Edgar-Conzen/EC16_on_ICE/EC16_ISA_V1.0.pdf

## EC16 Microprocessor Core

Instruction Set Architecture V1.0

## Summary

The EC16 is a microprocessor core written in VHDL with the following features

- 64K * 16-bit external memory space for code, data and I/O
- 256 * 16-bit internal ram for registers, pointers, stack and scratchpad
- 50 instructions
- instruction length: 46x one word, 4x two words
- speed: 18 one-cycle, 15 two-cycle, 9 three-cycle, 8 one/two-cycle (branch)
- 4 maskable prioritized interrupts

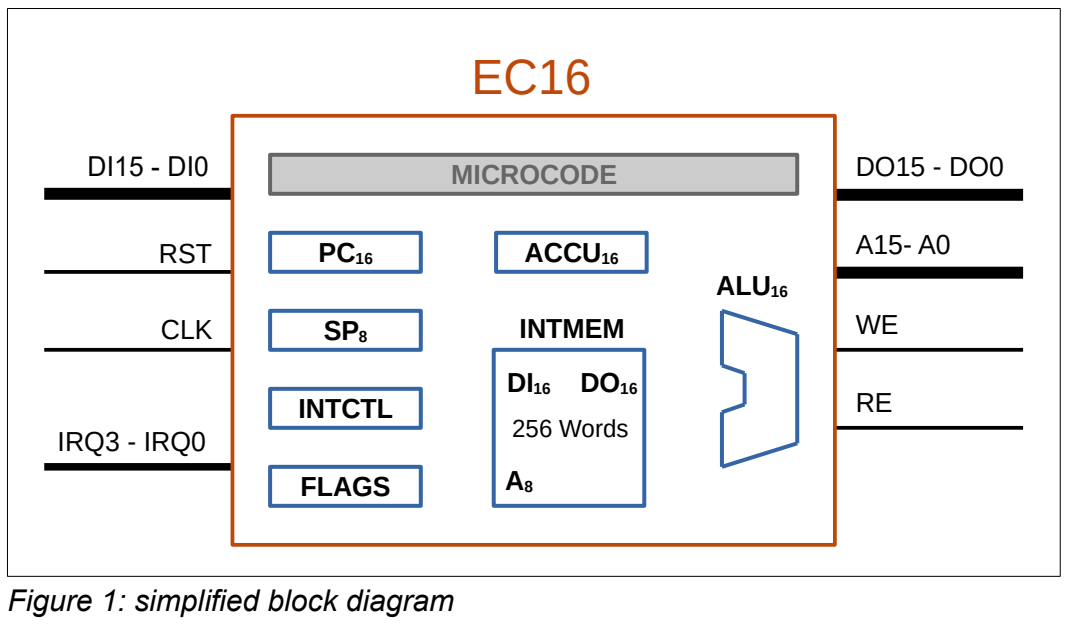
[picture p4: figure]
ACCU16; FLAGS; ALU16; INTMEM; 256 Words; INTCTL; MICROCODE; IRQ3 - IRQ0; CLK; RST; Figure 1: simplified block diagram

EC16 ISA V1.0 | Page 1/52

## EC16 Microprocessor Core

## Memory Model

The EC16 has two completely separate memory spaces, the external memory space (EXTMEM) and a small but faster accessible internal memory (INTMEM).

While the EXTMEM space can be populated as required with ram, rom and I/O devices, the INTMEM space is always fully populated with an EBRam organized as 256 x 16 bit.

The INTMEM cells can be used as registers, pointers to INTMEM or EXTMEM locations, scratchpad ram or stack space. The stack pointer is a separate register that is initialized to 0xFF at reset and grows towards 0x00. The usual caution has to be exercised to avoid a conflict between the growing stack and the other variables.

The EXTMEM must be populated with at least a small amount of ROM (pre-initialized RAM) beginning at address 0 since the reset and interrupt vectors are located there. The rest of the address space can be used as required.

The EC16 has a reduced instruction set architecture that is strongly focussed on the use of the faster INTMEM. Each of the 256 INTMEM locations can be used as a register or a pointer and its 8-bit address is encoded in the lower half of the opcode which speeds up fetch- and execution time. Read and write access to the EXTMEM space is handled by

Page 2/52 | EC16 ISA V1.0

External Memory (EXTMEM)
64K x 16 bit
0xFFFF

Code, Data, I/O

0x0020 | IRQ3
0x0018 | IRQ2
0x0010 | IRQ1
0x0008 | IRQ0
0x0000 | Reset

Internal Memory (INTMEM)
256 x 16 bit

Registers
Pointers
Sratchpad

0xFF
0x00

Stackpointer

## EC16 Microprocessor Core

only two instructions (MOVXI A INTMEM / MOVXI INTMEM A), both of which use an INTMEM cell to provide the address (indirect addressing via pointer). Nevertheless block operations can be very efficiently implemented with only three registers (source, destination and counter), in combination with the INC/DEC- and branch instructions.

## Interrupts

The EC16 has four interrupt inputs : IRQ0 – IRQ3. IRQ0 has the highest, IRQ3 the lowest priority. All four interupts are triggered by a rising edge. Prioritization and execution are handled via the INTCTL block. This block contains i.a. three registers : IRR (Interrupt Request Register), IMASK and IIP (Interrupt In Progress).

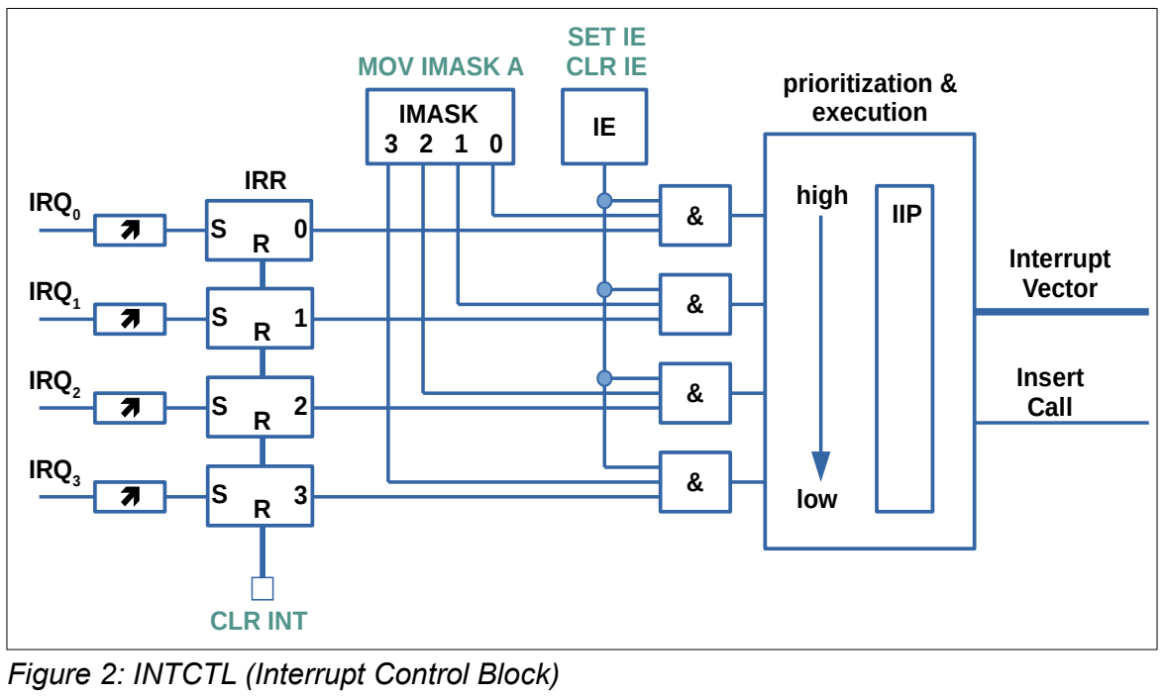
[picture p5: figure]
IMASK 3 2 1 0; IRQ0; IRQ1; IRQ2; IRQ3; CLR INT; IRR; MOV IMASK A; SET IE CLR IE; IIP; Interrupt Vector; Insert Call; prioritization & execution; high; low

A rising edge on IRQn is always registered in IRRn regardless of the state of IMASKn and IE. If, however, the rising edge occurs in the same clock cycle as a CLR INT instruction (which resets all IRR flags at once), the clear instruction takes precedence.

Figure 2: INTCTL (Interrupt Control Block)

## EC16 Microprocessor Core

IMASKn enables (1) or disables (0) IRQn. IMASK can be written with a MOV IMASK A instruction, which transfers the four least significant bits of the AKKU to IMASK3-0.

The flag IE enables (1) or disables (0) all interrupts simultaneously. IE can be set/reset with the SET IE, CLR IE and the MOV FLAGS A instructions.

Unless it is cleared by a CLR INT instruction, the IRRn flag remains set until its interrupt is executed. Interrupt execution happens as soon as IRRn , IMASKn and IE are all set and no interrupt with higher priority is in progress.

The current instruction is finished, IRRn is cleared and IIPn is set instead, blocking all lower level interrupts. Then the address of the next instruction is pushed onto the stack and a call to the corresponding interrupt vector is executed. IIPn stays set until the interrupt service routine is finished with a RETI instruction. RETI clears IIPn, pops the return address from the stack and resumes executing from where it left of.

Notice that as soon as IRRn is cleared, it will register the next rising edge on IRQn, even if the current ISR (Interrupt Service Routine) is still in progress.

Notice furthermore that at least one instruction of the interrupted program context is executed before the next interrupt is taken.

An IRQ with higher priority will interrupt the current ISR. This can be avoided if necessary by temporarily clearing the IE flag. Typical examples are atomic operations like a read-modify-write access to a peripheral or the handling of semaphores. Only the crucial instructions should be framed by a pair of CLR IE and SET IE.

Each interrupt level needs one word of stack space for the return address. No variables, registers or flags are saved automatically. It is up to the user to take care of it.

Page 4/52 | EC16 ISA V1.0

## EC16 Microprocessor Core

## Instruction Set

The EC16 opcodes consist of three fields

15 | 14 | 13 | 12 | 11 | 10 | 9 | 8 | 7 | 6 | 5 | 4 | 3 | 2 | 1 | 0
CYC1 | CYC0 | INST5 | INST4 | INST3 | INST2 | INST1 | INST0 | IA7 | IA6 | IA5 | IA4 | IA3 | IA2 | IA1 | IA0
- Bit 15:14 - CYC1:0 : number of clock cycles
- Bit 13:8 - INST5:0 : instruction index
- Bit 7:0 - IA7:0 : depending on instruction :
- INTMEM address (8 bit unsigned)
- Branch offset (8 bit signed)
- 0 if none of the above applies

Only the instructions JMPD U16, CALLD U16, LOAD A U16 and LOAD INTMEM U16 are two-word instructions, i.e. the opcode is followed by a 16 bit constant. In case of JMPD and CALLD this is the target address, in case of LOAD the value is loaded into the Accu respectively the INTMEM cell.

CYC1:0 | Number of clock cycles
00 | 1
01 | 2
10 | 3
11 | 2/1 (branch/no branch)

## EC16 Microprocessor Core

Instructions sorted by Function

Mnemonic | OPCode | Cycles | Words Arithmetic
ADD A INTMEM | 43u8 | 2 | 1 | A ← A + INTMEM
ADDC A INTMEM | 41u8 | 2 | 1 | A ← A + INTMEM + CARRY
CMP A INTMEM | 44u8 | 2 | 1 | Compare A and INTMEM
DEC INTMEM | 46u8 | 2 | 1 | Decrement INTMEM
INC INTMEM | 47u8 | 2 | 1 | Increment INTMEM
SUB A INTMEM | 42u8 | 2 | 1 | A ← A - INTMEM
SUBB A INTMEM | 40u8 | 2 | 1 | A ← A - INTMEM - CARRY
Logic
AND A INTMEM | 4Cu8 | 2 | 1 | A ← A AND INTMEM
NOT A | 2F00 | 1 | 1 | A ← ~A
OR A INTMEM | 4Du8 | 2 | 1 | A ← A OR INTMEM
ROL A | 2800 | 1 | 1 | C ← A(15 ← 14 ← … ← 2 ← 1 ← 0) ← C
ROR A | 2900 | 1 | 1 | C → A(15 → 14 → … → 2 → 1 → 0) → C
SHL A | 2A00 | 1 | 1 | C ← A(15 ← 14 ← … ← 2 ← 1 ← 0) ← '0'
SHR A | 2B00 | 1 | 1 | '0' → A(15 → 14 → … → 2 → 1 → 0) → C
SWAP A | 2500 | 1 | 1 | A ← A(15..8) A(7..0)
XOR A INTMEM | 4Eu8 | 2 | 1 | A ← A XOR INTMEM
Flag Manipulation
CLR C | 1000 | 1 | 1 | Clear CARRY flag
CLR IE | 0200 | 1 | 1 | Clear Interrupt Enable flag
CLR INT | 0400 | 1 | 1 | Clear all pending interrupts
SET C | 1100 | 1 | 1 | Set CARRY flag
SET IE | 0300 | 1 | 1 | Set Interrupt Enable flag
Program Flow Control
BRCC S8 | C0s8 | 2/1 | 1 | Branch if CARRY flag is '0'
BRCS S8 | C4s8 | 2/1 | 1 | Branch if CARRY flag is '1'
BRNC S8 | C2s8 | 2/1 | 1 | Branch if NEG flag is '0'
BRNS S8 | C6s8 | 2/1 | 1 | Branch if NEG flag is '1'
BROC S8 | C1s8 | 2/1 | 1 | Branch if OV flag is '0'
BROS S8 | C5s8 | 2/1 | 1 | Branch if OV flag is '1'
BRZC S8 | C3s8 | 2/1 | 1 | Branch if ZERO flag is '0'
BRZS S8 | C7s8 | 2/1 | 1 | Branch if ZERO flag is '0'
CALLD U16 | A100 | 3 | 2 | Call subroutine, Direct 16-bit EXTMEM address
CALLI INTMEM | A3u8 | 3 | 1 | Call subroutine, Indirect via pointer in INTMEM
JMPD U16 | A000 | 3 | 2 | Jump to Direct 16-bit EXTMEM address
JMPI INTMEM | A2u8 | 3 | 1 | Jump Indirect via pointer in INTMEM
RETI | 8500 | 3 | 1 | Return from Interrupt
RETS | 8400 | 3 | 1 | Return from Subroutine
Data Transport
LOAD A U16 | 6000 | 2 | 2 | Load 16-bit value into A
LOAD INTMEM U16 | 61u8 | 2 | 2 | Load 16-bit value into INTMEM
Page 6/52 | EC16 ISA V1.0

## EC16 Microprocessor Core

MOV A INTMEM | 50u8 | 2 | 1 | Move INTMEM to A
MOV A STATUS | 1400 | 1 | 1 | Move SP, IE and Flags to A
MOV FLAGS A | 1200 | 1 | 1 | Move A to Flags
MOV IMASK A | 0500 | 1 | 1 | Move A to Interrupt Mask
MOV INTMEM A | 16u8 | 1 | 1 | Move A to INTMEM
MOV SP A | 1300 | 1 | 1 | Move A to SP
MOVI A INTMEM | 80u8 | 3 | 1 | Move Indirect INTMEM to A. (See below)
MOVI INTMEM A | 52u8 | 2 | 1 | Move A to Indirect INTMEM. (See below)
MOVXI A INTMEM | 83u8 | 3 | 1 | Move EXTMEM (via pointer in INTMEM) to A
MOVXI INTMEM A | 82u8 | 3 | 1 | Move A (via pointer in INTMEM) to EXTMEM
POP A | 5100 | 2 | 1 | Pop value from Stack to A
PUSH A | 1500 | 1 | 1 | Push value in A to Stack
Miscellaneous
NOP | 0000 | 1 | 1 | No operation

Instructions sorted by Mnemonic

Mnemonic | OPCode | Cycles | Words | Action
ADD A INTMEM | 43u8 | 2 | 1 | A ← A + INTMEM
ADDC A INTMEM | 41u8 | 2 | 1 | A ← A + INTMEM + CARRY
AND A INTMEM | 4Cu8 | 2 | 1 | A ← A AND INTMEM
BRCC S8 | C0s8 | 2/1 | 1 | Branch if CARRY flag is '0'
BRCS S8 | C4s8 | 2/1 | 1 | Branch if CARRY flag is '1'
BRNC S8 | C2s8 | 2/1 | 1 | Branch if NEG flag is '0'
BRNS S8 | C6s8 | 2/1 | 1 | Branch if NEG flag is '1'
BROC S8 | C1s8 | 2/1 | 1 | Branch if OV flag is '0'
BROS S8 | C5s8 | 2/1 | 1 | Branch if OV flag is '1'
BRZC S8 | C3s8 | 2/1 | 1 | Branch if ZERO flag is '0'
BRZS S8 | C7s8 | 2/1 | 1 | Branch if ZERO flag is '0'
CALLD U16 | A100 | 3 | 2 | Call subroutine, Direct 16-bit EXTMEM address
CALLI INTMEM | A3u8 | 3 | 1 | Call subroutine, Indirect via pointer in INTMEM
CLR C | 1000 | 1 | 1 | Clear CARRY flag
CLR IE | 0200 | 1 | 1 | Clear Interrupt Enable flag
CLR INT | 0400 | 1 | 1 | Clear all pending interrupts
CMP A INTMEM | 44u8 | 2 | 1 | Compare A and INTMEM
DEC INTMEM | 46u8 | 2 | 1 | Decrement INTMEM
INC INTMEM | 47u8 | 2 | 1 | Increment INTMEM
JMPD U16 | A000 | 3 | 2 | Jump to Direct 16-bit EXTMEM address
JMPI INTMEM | A2u8 | 3 | 1 | Jump Indirect via pointer in INTMEM
LOAD A U16 | 6000 | 2 | 2 | Load 16-bit value into A
LOAD INTMEM U16 | 61u8 | 2 | 2 | Load 16-bit value into INTMEM
MOV A INTMEM | 50u8 | 2 | 1 | Move INTMEM to A
MOV A STATUS | 1400 | 1 | 1 | Move SP, IE and Flags to A
MOV FLAGS A | 1200 | 1 | 1 | Move A to Flags
MOV IMASK A | 0500 | 1 | 1 | Move A to Interrupt Mask
MOV INTMEM A | 16u8 | 1 | 1 | Move A to INTMEM
MOV SP A | 1300 | 1 | 1 | Move A to SP

## EC16 Microprocessor Core

MOVI A INTMEM | 80u8 | 3 | 1 | Move Indirect INTMEM to A. (See below)
MOVI INTMEM A | 52u8 | 2 | 1 | Move A to Indirect INTMEM. (See below)
MOVXI A INTMEM | 83u8 | 3 | 1 | Move EXTMEM (via pointer in INTMEM) to A
MOVXI INTMEM A | 82u8 | 3 | 1 | Move A (via pointer in INTMEM) to EXTMEM
NOP | 0000 | 1 | 1 | No operation
NOT A | 2F00 | 1 | 1 | A ← ~A
OR A INTMEM | 4Du8 | 2 | 1 | A ← A OR INTMEM
POP A | 5100 | 2 | 1 | Pop value from Stack to A
PUSH A | 1500 | 1 | 1 | Push value in A to Stack
RETI | 8500 | 3 | 1 | Return from Interrupt
RETS | 8400 | 3 | 1 | Return from Subroutine
ROL A | 2800 | 1 | 1 | C ← A(15 ← 14 ← … ← 2 ← 1 ← 0) ← C
ROR A | 2900 | 1 | 1 | C → A(15 → 14 → … → 2 → 1 → 0) → C
SET C | 1100 | 1 | 1 | Set CARRY flag
SET IE | 0300 | 1 | 1 | Set Interrupt Enable flag
SHL A | 2A00 | 1 | 1 | C ← A(15 ← 14 ← … ← 2 ← 1 ← 0) ← '0'
SHR A | 2B00 | 1 | 1 | '0' → A(15 → 14 → … → 2 → 1 → 0) → C
SUB A INTMEM | 42u8 | 2 | 1 | A ← A - INTMEM
SUBB A INTMEM | 40u8 | 2 | 1 | A ← A - INTMEM - CARRY
SWAP A | 2500 | 1 | 1 | A ← A(15..8) A(7..0)
XOR A INTMEM | 4Eu8 | 2 | 1 | A ← A XOR INTMEM

Instructions sorted by OPCode

Mnemonic | OPCode | Cycles | Words
NOP | 0000 | 1 | 1 | No operation
CLR IE | 0200 | 1 | 1 | Clear Interrupt Enable flag
SET IE | 0300 | 1 | 1 | Set Interrupt Enable flag
CLR INT | 0400 | 1 | 1 | Clear all pending interrupts
MOV IMASK A | 0500 | 1 | 1 | Move A to Interrupt Mask
CLR C | 1000 | 1 | 1 | Clear CARRY flag
SET C | 1100 | 1 | 1 | Set CARRY flag
MOV FLAGS A | 1200 | 1 | 1 | Move A to Flags
MOV SP A | 1300 | 1 | 1 | Move A to SP
MOV A STATUS | 1400 | 1 | 1 | Move SP, IE and Flags to A
PUSH A | 1500 | 1 | 1 | Push value in A to Stack
MOV INTMEM A | 16u8 | 1 | 1 | Move A to INTMEM
SWAP A | 2500 | 1 | 1 | A ← A(15..8) A(7..0)
ROL A | 2800 | 1 | 1 | C ← A(15 ← 14 ← … ← 2 ← 1 ← 0) ← C
ROR A | 2900 | 1 | 1 | C → A(15 → 14 → … → 2 → 1 → 0) → C
SHL A | 2A00 | 1 | 1 | C ← A(15 ← 14 ← … ← 2 ← 1 ← 0) ← '0'
SHR A | 2B00 | 1 | 1 | '0' → A(15 → 14 → … → 2 → 1 → 0) → C
NOT A | 2F00 | 1 | 1 | A ← ~A
SUBB A INTMEM | 40u8 | 2 | 1 | A ← A - INTMEM - CARRY
ADDC A INTMEM | 41u8 | 2 | 1 | A ← A + INTMEM + CARRY
SUB A INTMEM | 42u8 | 2 | 1 | A ← A - INTMEM
ADD A INTMEM | 43u8 | 2 | 1 | A ← A + INTMEM
Page 8/52 | EC16 ISA V1.0

## EC16 Microprocessor Core

CMP A INTMEM | 44u8 | 2 | 1 | Compare A and INTMEM
DEC INTMEM | 46u8 | 2 | 1 | Decrement INTMEM
INC INTMEM | 47u8 | 2 | 1 | Increment INTMEM
AND A INTMEM | 4Cu8 | 2 | 1 | A ← A AND INTMEM
OR A INTMEM | 4Du8 | 2 | 1 | A ← A OR INTMEM
XOR A INTMEM | 4Eu8 | 2 | 1 | A ← A XOR INTMEM
MOV A INTMEM | 50u8 | 2 | 1 | Move A to INTMEM
POP A | 5100 | 2 | 1 | Pop value from Stack to A
MOVI INTMEM A | 52u8 | 2 | 1 | Move A to Indirect INTMEM. (See below)
LOAD A U16 | 6000 | 2 | 2 | Load 16-bit value into A
LOAD INTMEM U16 | 61u8 | 2 | 2 | Load 16-bit value into INTMEM
MOVI A INTMEM | 80u8 | 3 | 1 | Move Indirect INTMEM to A. (See below)
MOVXI INTMEM A | 82u8 | 3 | 1 | Move A (via pointer in INTMEM) to EXTMEM
MOVXI A INTMEM | 83u8 | 3 | 1 | Move EXTMEM (via pointer in INTMEM) to A
RETS | 8400 | 3 | 1 | Return from Subroutine
RETI | 8500 | 3 | 1 | Return from Interrupt
JMPD U16 | A000 | 3 | 2 | Jump to Direct 16-bit EXTMEM address
CALLD U16 | A100 | 3 | 2 | Call subroutine, Direct 16-bit EXTMEM address
JMPI INTMEM | A2u8 | 3 | 1 | Jump Indirect via pointer in INTMEM
CALLI INTMEM | A3u8 | 3 | 1 | Call subroutine, Indirect via pointer in INTMEM
BRCC S8 | C0s8 | 2/1 | 1 | Branch if CARRY flag is '0'
BROC S8 | C1s8 | 2/1 | 1 | Branch if OV flag is '0'
BRNC S8 | C2s8 | 2/1 | 1 | Branch if NEG flag is '0'
BRZC S8 | C3s8 | 2/1 | 1 | Branch if ZERO flag is '0'
BRCS S8 | C4s8 | 2/1 | 1 | Branch if CARRY flag is '1'
BROS S8 | C5s8 | 2/1 | 1 | Branch if OV flag is '1'
BRNS S8 | C6s8 | 2/1 | 1 | Branch if NEG flag is '1'
BRZS S8 | C7s8 | 2/1 | 1 | Branch if ZERO flag is '0'

## EC16 Microprocessor Core

ADD A INTMEM | OP-Code | Arg | Words | Cycles
43u8 | - | 1 | 2

Function:
ACCU ← ACCU + INTMEM(u8);
PC ← PC + 1
Affected Flags: ZERO, NEG, OVER, CARRY

Description:
Add ACCU and INTMEM.
The contents of ACCU and INTMEM (addressed by the lower 8 bits of the OP-Code) are added and the result is stored into the ACCU.
The flags are affected as follows:
- ZERO | set when the result is zero, otherwise cleared
- NEG | set when d15 of result is one, otherwise cleared
- OVER | set when sign overflows, otherwise cleared
- CARRY | set when result is bigger than 16 bits, otherwise cleared

Remarks:
This instruction does not add the current CARRY to the two summands. It can be used for a 16-bit addition or to add the lowest two words in a higher precision (e.g. 64-bit) addition.
Page 10/52 | EC16 ISA V1.0

## EC16 Microprocessor Core

ADDC A INTMEM | OP-Code | Arg | Words | Cycles
41u8 | - | 1 | 2

Function:
ACCU ← ACCU + INTMEM(u8) + CARRY; PC ← PC + 1
Affected Flags: ZERO, NEG, OVER, CARRY

Description:
ADD CARRY, ACCU and INTMEM.
The contents of ACCU, INTMEM (addressed by the lower 8 bits of the OP-Code) and CARRY flag are added and the result is stored into ACCU.
The flags are affected as follows:
- ZERO | set when the result is zero, otherwise cleared
- NEG | set when d15 of result is one, otherwise cleared
- OVER | set when sign overflows, otherwise cleared
- CARRY | set when result is bigger than 16 bits, otherwise cleared

Remarks:
ADDC is normally used in higher precision (e.g. 64-bit) additions. At first the lowest two words are added with the ADD instruction. Then the higher words are added with the ADDC instruction, taking the carries into account.

## EC16 Microprocessor Core

AND A INTMEM | OP-Code | Arg | Words | Cycles
4Cu8 | - | 1 | 2

Function:
ACCU ← ACCU AND INTMEM(u8) PC ← PC + 1
Affected Flags: ZERO, NEG, OVER

Description:
And ACCU and INTMEM.
The contents of ACCU and INTMEM (addressed by the lower 8 bits of the OP-Code) are ANDed bit-wise and the result is stored into the ACCU.
The flags are affected as follows:
- ZERO | set when the result is zero, otherwise cleared
- NEG | set when d15 of result is one, otherwise cleared
- OVER | set to zero

Remarks:
none
Page 12/52 | EC16 ISA V1.0

## EC16 Microprocessor Core

BRxx | OP-Code | Arg | Words | Cycles
| Cxs8 | - | 1 | 2/1

Function:
Conditional branch
If condition is false then PC ← PC + 1
If condition is true then PC ← PC + s8 (branch)

Description:
Branch on (flag) clear / set.
If the condition is not met, the program simply continues with the next instruction. This takes one cycle.
If the condition is met, the offset (sign extended lower half of the OP-Code) is added to the program counter (PC). At this moment the PC is already pointing to the instruction following the branch instruction. So an offset of 0 will act as if no branch was taken. An offset of -1 will set the PC back to the branch instruction itself, thus creating an infinite loop. A branch reaches from -127 to +128 of its own address and takes two cycles.

x = branch taken
FLAG | CARRY | NEG | OVER | ZERO
Mnemonic (Opcode) | 0 | 1 | 0 | 1 | 0 | 1 | 0 | 1
BRCC (C0s8) | x
BRCS (C4s8) | | x
BRNC (C2s8) | | | x
BRNS (C6s8) | | | | x
BROC (C1s8) | | | | | x
BROS (C5s8) | | | | | | x
BRZC (C3s8) | | | | | | | x
BRZS (C7s8) | | | | | | | | x

Remarks: none

## EC16 Microprocessor Core

CALLD U16 | OP-Code | Arg | Words | Cycles
A100 | #U16 | 2 | 3

Function:
INTMEM(SP) ← PC
PC ← #U16
Affected Flags: none

Description:
Call direct address.
The call address is the argument, i.e. the word following the opcode. First the return address, which is the address of the instruction following the argument, is pushed onto the stack. Then the PC is loaded with the call address and execution continues there.

Remarks:
One word of stack space must be available
Page 14/52 | EC16 ISA V1.0

## EC16 Microprocessor Core

CALLI INTMEM | OP-Code | Arg | Words | Cycles
A3u8 | - | 1 | 3

Function:
INTMEM(SP) ← PC+1
PC ← INTMEM(u8)
Affected Flags: none

Description:
Call indirect via pointer in INTMEM.
The call address is in INTMEM (which is addressed by the lower 8 bits of the OP-Code). First the return address, which is the address of the instruction following the CALL, is pushed onto the stack. Then the PC is loaded with the call address and execution continues there.

Remarks:
One word of stack space must be available

## EC16 Microprocessor Core

CLR C | OP-Code | Arg | Words | Cycles
1000 | - | 1 | 1

Function:
CARRY ← 0
PC ← PC + 1
Affected Flags: Carry

Description:
Clear CARRY.
The CARRY flag is set to zero. This can be used to prepare shift and rotate instructions.

Remarks:
none
Page 16/52 | EC16 ISA V1.0

## EC16 Microprocessor Core

CLR IE | OP-Code | Arg | Words | Cycles
0200 | - | 1 | 1

Function:
IE ← 0
PC ← PC + 1
Affected Flags: IE

Description:
Clear Interrupt Enable flag.
The Interrupt Enable flag is set to zero. Interrupts already in progress will not be affected. Pending interrupts will stay pending but will not be taken until IE is set to one.

Remarks:
none

## EC16 Microprocessor Core

CLR INT | OP-Code | Arg | Words | Cycles
0400 | - | 1 | 1

Function:
IRRx ← 0
PC ← PC + 1
Affected Flags: none

Description:
Clear Interrupts.
All Interrupt Request Registers that hold pending interrupts are cleared to zero thus cancelling the requests.

Remarks:
none
Page 18/52 | EC16 ISA V1.0

## EC16 Microprocessor Core

CMP A INTMEM | OP-Code | Arg | Words | Cycles
| 4Au8 | - | 1 | 2

Function:
(Discarded) ← ACCU - INTMEM(u8);
PC ← PC + 1
Affected Flags: ZERO, NEG, OVER, CARRY

Description:
Compare ACCU and INTMEM.
The content of INTMEM (addressed by the lower 8 bits of the OP-Code) is subtracted from the ACCU. The result is discarded (not written to the ACCU) but the flags are set like in a normal SUB instruction. The flags are affected as follows:
ZERO: | set when the result is zero, otherwise cleared
NEG: | set when d15 of result is one, otherwise cleared
OVER: | set when result overflows into d15, otherwise cleared
CARRY: | (=borrow) set when result is less then zero, otherwise cleared

The ZERO and the CARRY flag show the result of the comparison

ZERO | CARRY | Comparison result
1 | x | A = INTMEM(u8)
0 | x | A ǂ INTMEM(u8)
0 | 0 | A > INTMEM(u8)
0 | 1 | A < INTMEM(u8)

Remarks:
none

## EC16 Microprocessor Core

DEC INTMEM | OP-Code | Arg | Words | Cycles
46u8 | - | 1 | 2

Function:
INTMEM(u8) ← INTMEM(u8) - 1;
PC ← PC + 1
Affected Flags: ZERO, NEG, OVER, CARRY

Description:
Decrement INTMEM.
The content of INTMEM (addressed by the lower 8 bits of the OP-Code) is decremented by one and stored back to the same location.
The flags are affected as follows:
ZERO: | set when the result is zero, otherwise cleared
NEG: | set when d15 of result is one, otherwise cleared
OVER: | set to zero
CARRY: | (=borrow) set when result is less then zero, otherwise cleared

Remarks:
This can be used for block transfers where the INTMEM serves as address pointer or as a loop counter.
Page 20/52 | EC16 ISA V1.0

## EC16 Microprocessor Core

INC INTMEM | OP-Code | Arg | Words | Cycles
47u8 | - | 1 | 2

Function:
INTMEM(u8) ← INTMEM(u8) + 1;
PC ← PC + 1
Affected Flags: ZERO, NEG, OVER, CARRY

Description:
Increment INTMEM.
The content of INTMEM (addressed by the lower 8 bits of the OP-Code) is incremented by one and stored back to the same location.
The flags are affected as follows:
ZERO: | set when the result is zero, otherwise cleared
NEG: | set when d15 of result is one, otherwise cleared
OVER: | set to zero
CARRY: | set when result is bigger than 16 bits, otherwise cleared

Remarks:
This can be used for block transfers where the INTMEM serves as address pointer or as a loop counter.

## EC16 Microprocessor Core

JMPD U16 | OP-Code | Arg | Words | Cycles
A000 | U16 | 2 | 3

Function:
PC ← #U16
Affected Flags: none

Description:
Jump directly to address.
The jump address is the argument, i.e. the word following the opcode. The PC is loaded with the jump address and execution continues there.

Remarks:
none
Page 22/52 | EC16 ISA V1.0

## EC16 Microprocessor Core

JMPI INTMEM | OP-Code | Arg | Words | Cycles
A2u8 | - | 1 | 3

Function:
PC ← INTMEM(u8)
Affected Flags: none

Description:
Jump indirect via pointer in INTMEM.
The jump address is in INTMEM (which is addressed by the lower 8 bits of the OP-Code). The jump address is loaded into the PC and execution continues there.

Remarks:
none

## EC16 Microprocessor Core

MOV INTMEM A | OP-Code | Arg | Words | Cycles
16u8 | - | 1 | 1

Function:
INTMEM(u8) ← A
PC ← PC + 1
Affected Flags: none

Description:
Move ACCU to INTMEM.
Copy ACCU to INTMEM (which is addressed by the lower 8 bits of the OP-Code)

Remarks:
none
Page 24/52 | EC16 ISA V1.0

## EC16 Microprocessor Core

MOV A INTMEM | OP-Code | Arg | Words | Cycles
50u8 | - | 1 | 2

Function:
A ← INTMEM(u8)
PC ← PC + 1
Affected Flags: none

Description:
Move INTMEM to ACCU.
Copy INTMEM (addressed by the lower 8 bits of the OP-Code) to ACCU.

Remarks:
none

## EC16 Microprocessor Core

MOV A STATUS | OP-Code | Arg | Words | Cycles
| 1400 | - | 1 | 1

Function:
A ← STATUS
PC ← PC + 1
Affected Flags: none

Description:
Move STATUS to ACCU.
The STATUS register reflects the stack pointer and the flags
d15 - d8 | d7 - d5 | d4 | d3 | d2 | d1 | d0
STACK POINTER | 000 | IE | ZERO | NEG | OVER | CARRY

Remarks:
none
Page 26/52 | EC16 ISA V1.0

## EC16 Microprocessor Core

MOV FLAGS A | OP-Code | Arg | Words | Cycles
| 1200 | - | 1 | 1

Function:
FLAGS ← A
PC ← PC + 1

Description:
Move ACCU to FLAGS.
Copy the 5 least significant bits of ACCU to the flag bits.
With this instruction all flags can be initialized to a specific value.
d15 - d5 | d4 | d3 | d2 | d1 | d0
- - - - - - - - - - - | IE | ZERO | NEG | OVER | CARRY

Remarks:
Flags IE and CARRY can also be set and cleared with their dedicated instructions.
The stack pointer can only be loaded with its dedicated instruction (MOV SP A)

## EC16 Microprocessor Core

MOV IMASK A | OP-Code | Arg | Words | Cycles
0500 | - | 1 | 1

Function:
IMASK ← A
PC ← PC + 1
Affected Flags: none

Description:
Move ACCU to IMASK.
The number of bits in the IMASK register depends on the interrupt hardware but they always start at d0 and are arranged gapless. If there are e.g. four interrupt lines, the mask bits are d0 – d3 with d0 (IRQ0) having the highest and d3 (IRQ3) the lowest priority.
For an interrupt to be enabled its corresponding IMASK bit must be set to one.

Remarks:
The IMASK register is write only
Page 28/52 | EC16 ISA V1.0

## EC16 Microprocessor Core

MOV SP A | OP-Code | Arg | Words | Cycles
1300 | - | 1 | 1

Function:
SP ← A
PC ← PC + 1
Affected Flags: none

Description:
Move ACCU to SP.
Copy lower 8 bits of ACCU to stack pointer

Remarks:
To read back the content of register SP use the instructions MOV A STATUS and SWAP ACCU.

## EC16 Microprocessor Core

LOAD INTMEM U16 | OP-Code | Arg | Words | Cycles
61u8 | U16 | 2 | 2

Function:
INTMEM(u8) ← #U16
PC ← PC + 2
Affected Flags: none

Description:
Load 16-bit value into INTMEM.
INTMEM is addressed by the lower 8 bits of the OP-Code

Remarks:
none
Page 30/52 | EC16 ISA V1.0

## EC16 Microprocessor Core

LOAD A U16 | OP-Code | Arg | Words | Cycles
6000 | U16 | 2 | 2

Function:
A ← #U16
PC ← PC + 2
Affected Flags: none

Description:
Load 16-bit value into ACCU.

Remarks:
none

## EC16 Microprocessor Core

MOVI INTMEM A | OP-Code | Arg | Words | Cycles
52u8 | - | 1 | 2

Function:
INTMEM ( (low) INTMEM (u8) ) ← A PC ← PC + 1
Affected Flags: none

Description:
Move indirect ACCU to INTMEM.
The INTMEM argument is not the target address itself but a pointer to it. At first this pointer is fetched from INTMEM. Its lower 8 bits then address the actual INTMEM target location where the content of ACCU is copied to. The pointers upper 8 bits are ignored. This addressing mode is useful for moving and/or manipulating blocks of INTMEM in a loop by simply incrementing or decrementing the pointer.

Remarks:
none
Page 32/52 | EC16 ISA V1.0

## EC16 Microprocessor Core

MOVI A INTMEM | OP-Code | Arg | Words | Cycles
80u8 | - | 1 | 3

Function:
A ← INTMEM ( (low) INTMEM (u8) ) PC ← PC + 1
Affected Flags: none

Description:
Move indirect INTMEM to ACCU.
The INTMEM argument is not the source address itself but a pointer to it. At first this pointer is fetched from INTMEM. Its lower 8 bits then address the actual INTMEM source location whose content is copied to the ACCU. The pointers upper 8 bits are ignored. This addressing mode is useful for moving and/or manipulating blocks of INTMEM in a loop by simply incrementing or decrementing the pointer.

Remarks:
none

## EC16 Microprocessor Core

MOVXI INTMEM A | OP-Code | Arg | Words | Cycles
82u8 | - | 1 | 3

Function:
EXTMEM (INTMEM (u8) ) ← A
PC ← PC + 1
Affected Flags: none

Description:
Move ACCU to EXTMEM addressed by pointer in INTMEM.
At first the INTMEM is addressed by the lower 8 bits of the OP-Code. This memory location serves as a pointer. It points to the actual EXTMEM target address where the content of ACCU is copied to. The indirect addressing can be used to move and/or manipulate blocks of EXTMEM in a loop by incrementing or decrementing the pointer.

Remarks:
none
Page 34/52 | EC16 ISA V1.0

## EC16 Microprocessor Core

MOVXI A INTMEM | OP-Code | Arg | Words | Cycles
83u8 | - | 1 | 3

Function:
A ← EXTMEM (INTMEM (u8) )
PC ← PC + 1
Affected Flags: none

Description:
Move EXTMEM addressed by INTMEM to ACCU.
At first the INTMEM is addressed by the lower 8 bits of the OP-Code. This memory location serves as a pointer. It points to the actual EXTMEM location whose content is copied to ACCU. The indirect addressing can be used to move and/or manipulate blocks of EXTMEM in a loop by incrementing or decrementing the pointer.

Remarks:
none

## EC16 Microprocessor Core

NOP | OP-Code | Arg | Words | Cycles
0000 | - | 1 | 1

Function:
PC ← PC + 1
Affected Flags: none

Description:
No operation.
Only the PC is incremented by one. This instruction can be used for short delays or to fill unused memory.

Remarks:
none
Page 36/52 | EC16 ISA V1.0

## EC16 Microprocessor Core

NOT A | OP-Code | Arg | Words | Cycles
2F00 | - | 1 | 1

Function:
ACCU ← NOT ACCU
PC ← PC + 1
Affected Flags: ZERO, NEG, OVER

Description:
Negate ACCU.
All bits of ACCU are negated and the result is stored into ACCU. The flags are affected as follows:
- ZERO | set when the result is zero, otherwise cleared
- NEG | set when d15 of result is one, otherwise cleared
- OVER | set to zero

Remarks:
Two consecutive NOT A leave the ACCU unchanged but set / clear the flags ZERO and NEG. This can be used to test if the ACCU contains zero or a negative value.

## EC16 Microprocessor Core

OR A INTMEM | OP-Code | Arg | Words | Cycles
4Du8 | - | 1 | 2

Function:
ACCU ← ACCU OR INTMEM(u8)
PC ← PC + 1
Affected Flags: ZERO, NEG, OVER

Description:
Or ACCU with INTMEM.
The contents of ACCU and INTMEM (addressed by the lower 8 bits of the OP-Code) are ORed bit-wise and the result is stored into the ACCU.
The flags are affected as follows:
- ZERO | set when the result is zero, otherwise cleared
- NEG | set when d15 of result is one, otherwise cleared
- OVER | set to zero

Remarks:
none
Page 38/52 | EC16 ISA V1.0

## EC16 Microprocessor Core

POP A | OP-Code | Arg | Words | Cycles
5100 | - | 1 | 2

Function:
SP ← SP + 1
ACCU ← INTMEM(SP)
PC ← PC + 1
Affected Flags: none

Description:
Pop ACCU.
At first the stack pointer is incremented by one. Next the content of INTMEM (addressed by the stack pointer) is copied into ACCU.

Remarks:
none

## EC16 Microprocessor Core

PUSH A | OP-Code | Arg | Words | Cycles
1500 | - | 1 | 1

Function:
INTMEM(SP) ← ACCU
SP ← SP - 1
PC ← PC + 1
Affected Flags: none

Description:
Push ACCU.
At first the content of ACCU is copied into INTMEM (addressed by the stack pointer). Next the stack pointer is decremented by one.

Remarks:
none
Page 40/52 | EC16 ISA V1.0

## EC16 Microprocessor Core

RETI | OP-Code | Arg | Words | Cycles
8500 | - | 1 | 3

Function:
SP ← SP + 1
IIPx ← 0
PC ← INTMEM(SP)
Affected Flags: none

Description:
Return from interrupt.
At first the stack pointer is incremented by one and the execution of the current interrupt is ended by clearing the correspondent IIPx-Flag (Interrupt In Progress). Next the content of INTMEM (addressed by the stack pointer) is copied into PC and execution continues from there.

Remarks:
A valid return address must be on the stack from an interrupt call

## EC16 Microprocessor Core

RETS | OP-Code | Arg | Words | Cycles
8400 | - | 1 | 3

Function:
SP ← SP + 1
PC ← INTMEM(SP)
Affected Flags: none

Description:
Return from subroutine.
At first the stack pointer is incremented by one. Next the content of INTMEM (addressed by the stack pointer) is copied into PC and execution continues from there.

Remarks:
A valid return address must be on the stack from a previous CALL instruction
Page 42/52 | EC16 ISA V1.0

## EC16 Microprocessor Core

ROL A | OP-Code | Arg | Words | Cycles
2800 | - | 1 | 1

Function:
CARRY ← ACCU(15 ← 14 ← … ← 2 ← 1 ← 0) ← CARRY PC ← PC + 1
Affected Flags: ZERO, NEG, OVER, CARRY

Description:
Rotate Left Accumulator through CARRY.
The ACCU is shiftet left one bit position. Its lowest bit receives the content of the CARRY. Its highest bit in turn goes into the CARRY.

The other flags are affected as follows:
- ZERO | set when the result is zero, otherwise cleared
- NEG | set when d15 of result is one, otherwise cleared
- OVER | set to zero

Remarks:
The CARRY can be set or cleared beforehand to insert a one or a zero.

## EC16 Microprocessor Core

ROR A | OP-Code | Arg | Words | Cycles
2900 | - | 1 | 1

Function:
CARRY → ACCU(15 → 14 → … → 2 → 1 → 0) → CARRY PC ← PC + 1
Affected Flags: ZERO, NEG, OVER, CARRY

Description:
Rotate Right Accumulator through CARRY.
The ACCU is shiftet right one bit position. Its highest bit receives the content of the CARRY. Its lowest bit in turn goes into the CARRY.

The other flags are affected as follows:
- ZERO | set when the result is zero, otherwise cleared
- NEG | set when d15 of result is one, otherwise cleared
- OVER | set to zero

Remarks:
The CARRY can be set or cleared beforehand.
Page 44/52 | EC16 ISA V1.0

## EC16 Microprocessor Core

SET C | OP-Code | Arg | Words | Cycles
1100 | - | 1 | 1

Function:
CARRY ← 1
PC ← PC + 1
Affected Flags: CARRY

Description:
Set CARRY flag.
This can be used to prepare shift and rotate instructions.

Remarks:
none

## EC16 Microprocessor Core

SET IE | OP-Code | Arg | Words | Cycles
0300 | - | 1 | 1

Function:
IE ← 1
PC ← PC + 1
Affected Flags: IE

Description:
Set Interrupt Enable flag.
All pending and enabled interrupts will be accepted in the order of their priority. (INT0 = highest priority)

Remarks:
none
Page 46/52 | EC16 ISA V1.0

## EC16 Microprocessor Core

SHL A | OP-Code | Arg | Words | Cycles
2A00 | - | 1 | 1

Function:
CARRY ← ACCU(15 ← 14 ← … ← 2 ← 1 ← 0) ← 0 PC ← PC + 1
Affected Flags: ZERO, NEG, OVER, CARRY

Description:
Shift Left Accumulator into CARRY.
The ACCU is shiftet left one bit position. Its lowest bit receives a zero. Its highest bit in turn goes into the CARRY.

The other flags are affected as follows:
- ZERO | set when the result is zero, otherwise cleared
- NEG | set when d15 of result is one, otherwise cleared
- OVER | set to zero

Remarks:
SHL A is equivalent to multiply by 2

## EC16 Microprocessor Core

SHR A | OP-Code | Arg | Words | Cycles
2B00 | - | 1 | 1

Function:
0 → ACCU(15 → 14 → … → 2 → 1 → 0) → CARRY PC ← PC + 1
Affected Flags: ZERO, NEG, OVER, CARRY

Description:
Shift Right Accumulator into CARRY.
The ACCU is shiftet right one bit position. Its highest bit receives a zero. Its lowest bit in turn goes into the CARRY.

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

Remarks:
SHR A is equivalent to division by 2
Page 48/52 | EC16 ISA V1.0

## EC16 Microprocessor Core

SUB A INTMEM | OP-Code | Arg | Words | Cycles
42u8 | - | 1 | 2

Function:
ACCU ← ACCU - INTMEM(u8);
PC ← PC + 1
Affected Flags: ZERO, NEG, OVER, CARRY

Description:
The content of INTMEM (addressed by the lower 8 bits of the OP-Code) is subtracted from ACCU and the result is stored into ACCU.
The flags are affected as follows:
- ZERO | set when the result is zero, otherwise cleared
- NEG | set when d15 of result is one, otherwise cleared
- OVER | set when sign overflows, otherwise cleared
- CARRY | (=borrow) set when result is less then zero, otherwise cleared

Remarks:
This instruction does not subtract the current CARRY. It can be used for a 16-bit subtraction or to subtract the lowest two words in a higher precision (e.g. 64-bit) subtraction.

## EC16 Microprocessor Core

SUBB A INTMEM | OP-Code | Arg | Words | Cycles
40u8 | - | 1 | 2

Function:
ACCU ← ACCU - INTMEM(u8) - CARRY; PC ← PC + 1
Affected Flags: ZERO, NEG, OVER, CARRY

Description:
Subtract with borrow.
The content of INTMEM (addressed by the lower 8 bits of the OP-Code) and CARRY are subtracted from ACCU and the result is stored into ACCU.
The flags are affected as follows:
- ZERO | set when the result is zero, otherwise cleared
- NEG | set when d15 of result is one, otherwise cleared
- OVER | set when sign overflows, otherwise cleared
- CARRY | (=borrow) set when result is less then zero, otherwise cleared

Remarks:
SUBB is normally used in higher precision (e.g. 64-bit) subtractions. The lowest two words are subtracted with the SUB instruction. Then the higher words are subtracted with the SUBB instruction, taking the carries (borrows) into account.
Page 50/52 | EC16 ISA V1.0

## EC16 Microprocessor Core

SWAP A | OP-Code
| 2500

Arg

Words
1

Cycles
1

Function:
ACCU(15 .. 8) ← ACCU(7 .. 0), ACCU(7 .. 0) ← ACCU(15 .. 8) PC ← PC + 1
Affected Flags: ZERO, NEG, OVER

Description:
SWAP ACCU
Swap the high and low bytes of ACCU.
The flags are affected as follows:
- ZERO | set when the result is zero, otherwise cleared
- NEG | set when d15 of result is one, otherwise cleared
- OVER | set to zero

Remarks:

## EC16 Microprocessor Core

XOR A INTMEM | OP-Code | Arg | Words | Cycles
4Eu8 | - | 1 | 2

Function:
ACCU ← ACCU XOR INTMEM(u8) PC ← PC + 1
Affected Flags: ZERO, NEG, OVER

Description:
The contents of ACCU and INTMEM (addressed by the lower 8 bits of the OP-Code) are XORed bit-wise and the result is stored into the ACCU.
The flags are affected as follows:
- ZERO | set when the result is zero, otherwise cleared
- NEG | set when d15 of result is one, otherwise cleared
- OVER | set to zero

Remarks:
none
Page 52/52 | EC16 ISA V1.0
