Edgar-Conzen/EC16_on_ICE/images/EC16 on ICY40.jpg

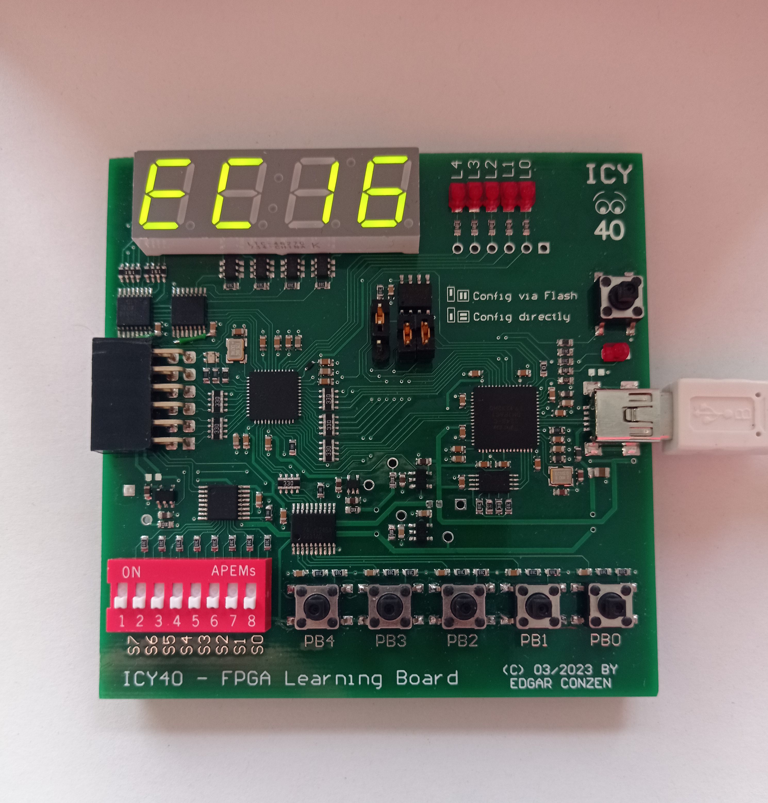
images/EC16 on ICY40.jpg
