Edgar-Conzen/EC16_on_ICE/images/ICE40.jpg

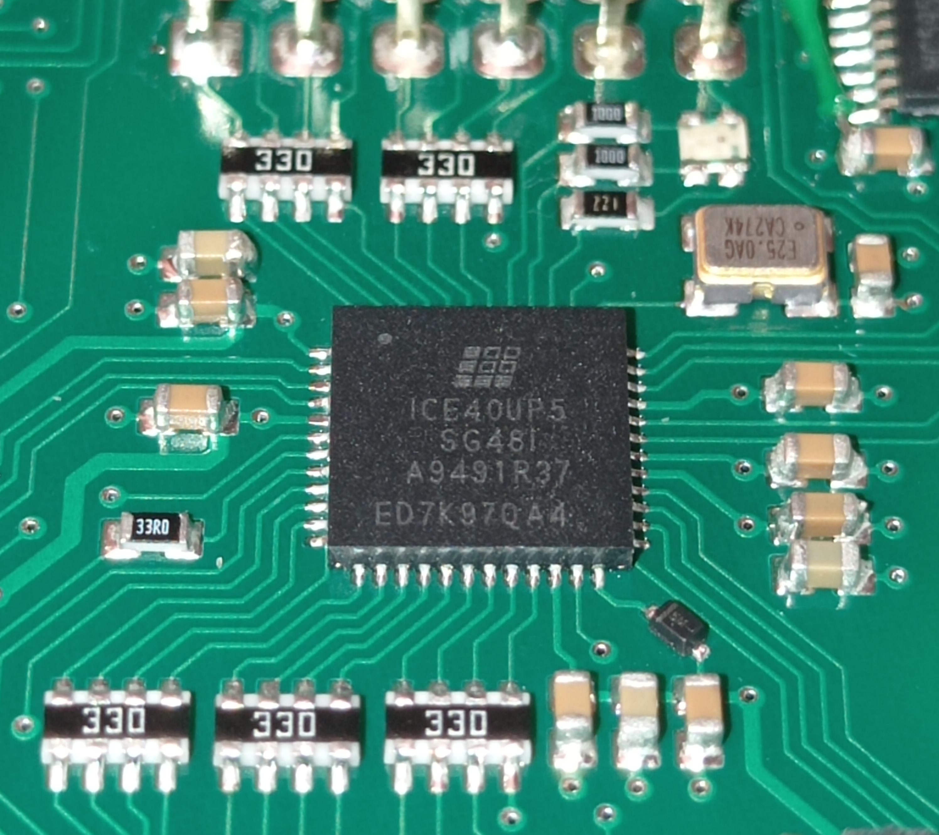
images/ICE40.jpg
