Edgar-Conzen/EC16_on_ICE/(list of files, drawings)

Other design files:
source/logisim/EC16.circ
