Edgar-Conzen/EC16_on_ICE/(commit log)

2024-01-31 Radiant Version 2023.1.1.200.1
    Complete Lattice Radiant project (2023.1.1.200.1 )with VHDL sources for the EC16 CPU, FART (115.200 Baud, 1 8,1,N) and ICY40 board specific files (ICE40UP5K-SG48).
    EC16 assembler source code for the ECMON monitor program including ec16asm.py assembler
    [ec16_on_ice_impl_1_vo.sdf, pll_25_20.cfg]
2024-02-02 Update README.md
    Added picture of ICY40 dev board
2024-02-03 Update ec16asm.py
    A new output file format is added: *.ecm for the upload with ECMON. Notice however that a brief pause is needed after each line. The best way to do this is with Tera Term. Goto Setup -> Additional settings -> Copy and Paste -> Paste delay per line = 1ms. Open the .ecm file with a text editor, select all text, copy, then paste it into Teram term with Alt-V or right mouse button.
2024-02-07 Create EC16.circ
    Added the logisim evolution model of the EC16
    [EC16.circ]
2024-02-07 Added instruction SWAP A
    For easier handling of byte oriented device (e.g. COM-Port) and more efficient use of memory, the SWAP A instruction was added.
    [EC16.circ]
